przmajerczak/stm32_oscilloscope-device/device_schematic/adc_speed_switch.kicad_sch

## KiCad design device_schematic/adc_speed_switch.kicad_sch (2025-07-13)

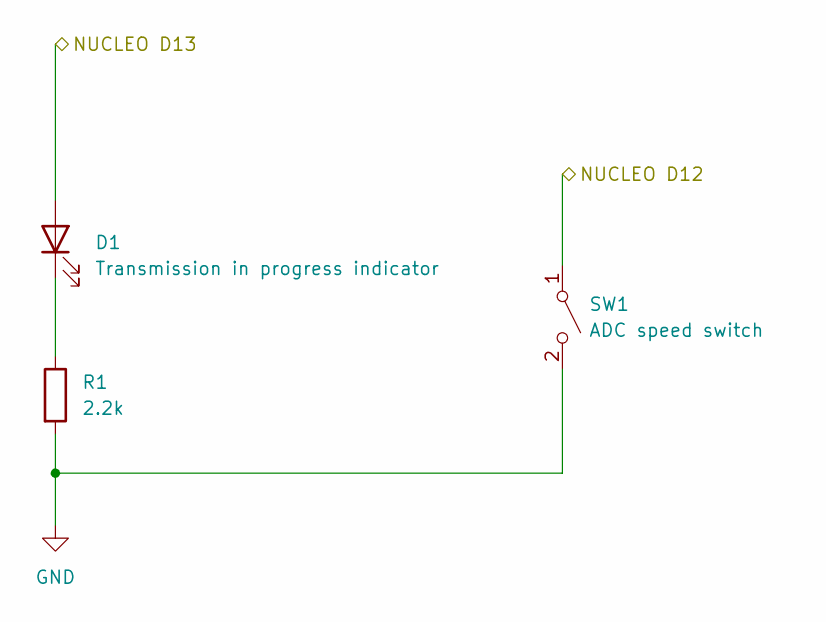
[picture p1: schematic adc_speed_switch.kicad_sch]

Parts:
D1: Transmission in progress indicator
R1: 2.2k
SW1: ADC speed switch

Connections:
NUCLEO D12: SW1.1 (A)
NUCLEO D13: D1.2 (A)
unnamed: D1.1 (K), R1.1
unnamed: R1.2, SW1.2 (B)
