przmajerczak/stm32_oscilloscope-device/device_schematic/negative_supply.kicad_sch

## KiCad design device_schematic/negative_supply.kicad_sch (2025-07-14)

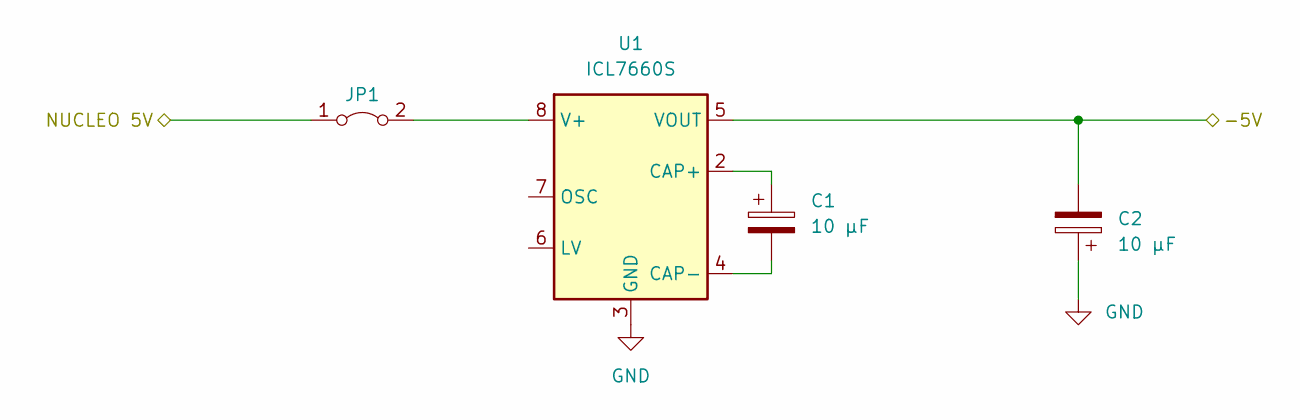
[picture p2: schematic negative_supply.kicad_sch]

Parts:
C1, C2: 10 µF
JP1: (no value)
U1: ICL7660S

Connections:
-5V: C2.2, U1.5 (VOUT)
NUCLEO 5V: JP1.1 (A)
unnamed: C1.1, U1.2 (CAP+)
unnamed: C1.2, U1.4 (CAP-)
unnamed: JP1.2 (B), U1.8 (V+)
