przmajerczak/stm32_oscilloscope-device/device_schematic/usb-c_connector.kicad_sch

## KiCad design device_schematic/usb-c_connector.kicad_sch (2025-07-14)

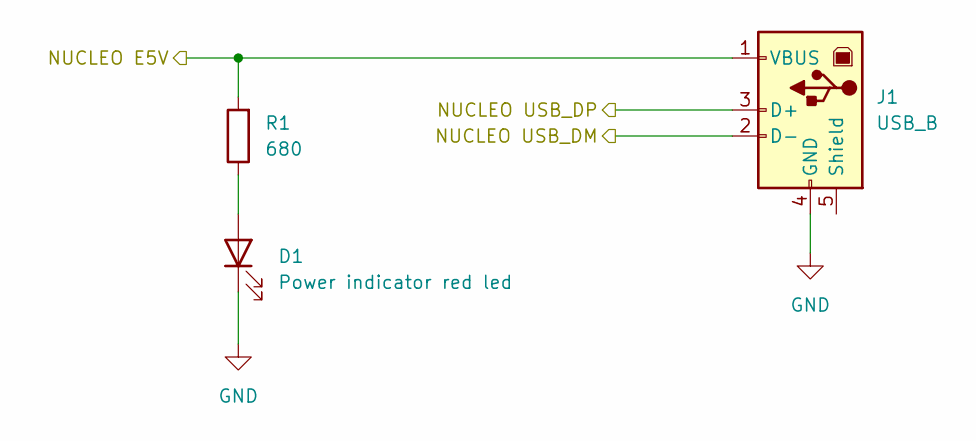
[picture p3: schematic usb-c_connector.kicad_sch]

Parts:
D1: Power indicator red led
J1: USB_B
R1: 680

Connections:
NUCLEO E5V: J1.1 (VBUS), R1.2
NUCLEO USB_DM: J1.2 (D-)
NUCLEO USB_DP: J1.3 (D+)
unnamed: D1.2 (A), R1.1
