przmajerczak/stm32_oscilloscope-device/device_schematic/subcircuits/adc_sample_time_selector.kicad_sch

## KiCad design device_schematic/subcircuits/adc_sample_time_selector.kicad_sch (2025-07-18)

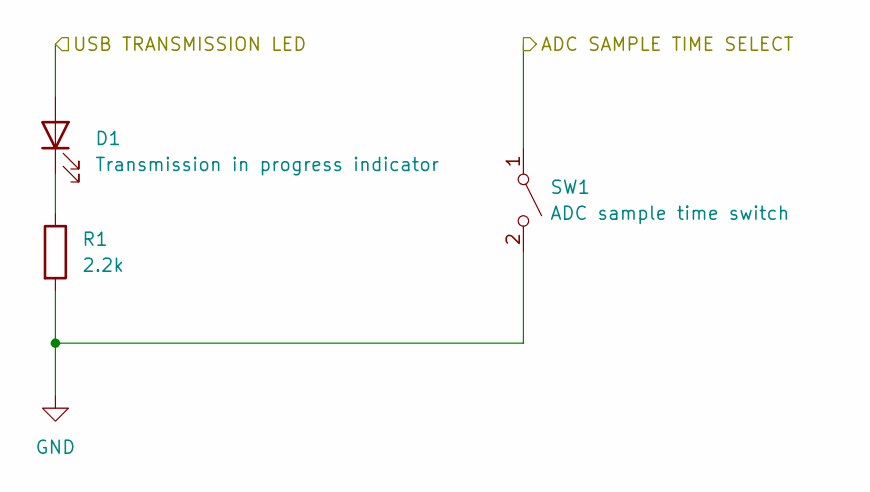
[picture p4: schematic adc_sample_time_selector.kicad_sch]

Parts:
D1: Transmission in progress indicator
R1: 2.2k
SW1: ADC sample time switch

Connections:
ADC SAMPLE TIME SELECT: SW1.1 (A)
unnamed: D1.1 (K), R1.1
unnamed: R1.2, SW1.2 (B)
USB TRANSMISSION LED: D1.2 (A)
