przmajerczak/stm32_oscilloscope-device/device_schematic/subcircuits/negative_supply_generator.kicad_sch

## KiCad design device_schematic/subcircuits/negative_supply_generator.kicad_sch (2025-07-18)

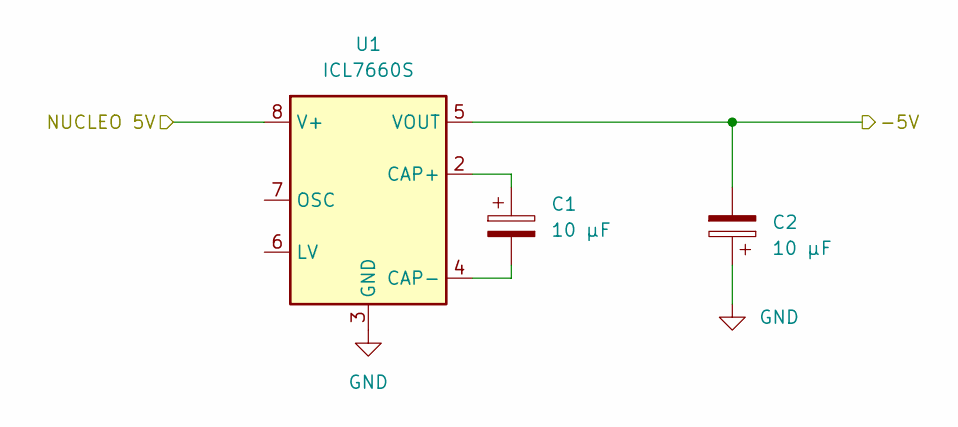
[picture p5: schematic negative_supply_generator.kicad_sch]

Parts:
C1, C2: 10 µF
U1: ICL7660S

Connections:
-5V: C2.2, U1.5 (VOUT)
NUCLEO 5V: U1.8 (V+)
unnamed: C1.1, U1.2 (CAP+)
unnamed: C1.2, U1.4 (CAP-)
