przmajerczak/stm32_oscilloscope-device/device_schematic/subcircuits/signal_processing_unit.kicad_sch

## KiCad design device_schematic/subcircuits/signal_processing_unit.kicad_sch (2025-07-18)

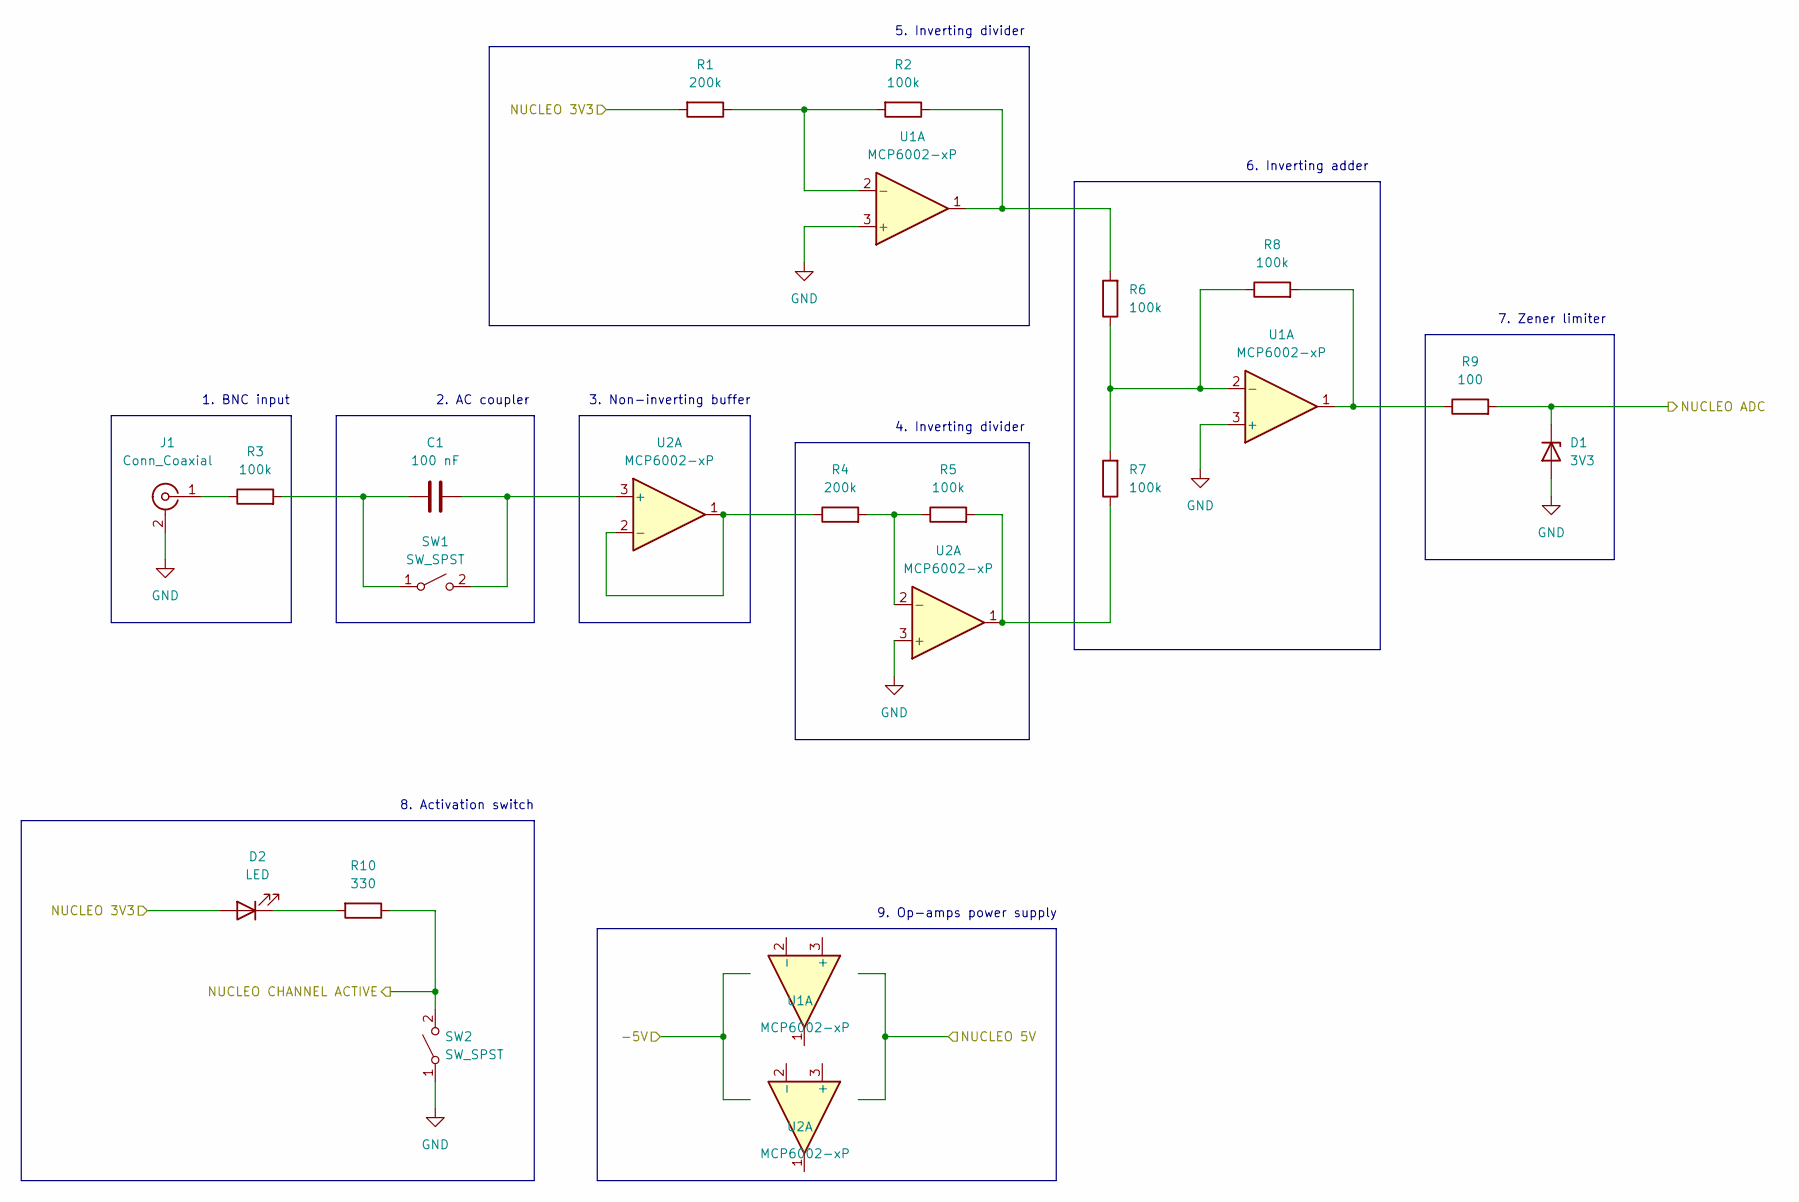
[picture p6: schematic signal_processing_unit.kicad_sch]

Parts:
C1: 100 nF
D1: 3V3
D2: LED
J1: Conn_Coaxial
R1, R4: 200k
R2, R3, R5, R6, R7, R8: 100k
R9: 100
R10: 330
SW1, SW2: SW_SPST
U1, U2: MCP6002-xP

Connections:
NUCLEO 3V3: D2.2 (A), R1.2
NUCLEO ADC: D1.1 (K), R9.2
NUCLEO CHANNEL ACTIVE: R10.1, SW2.2 (B)
unnamed: C1.1, R3.2, SW1.1 (A)
unnamed: C1.2, SW1.2 (B), U2.3 (+)
unnamed: D2.1 (K), R10.2
unnamed: J1.1 (In), R3.1
unnamed: R1.1, R2.2, U1.2 (-)
unnamed: R2.1, R6.2, U1.1
unnamed: R4.1, U2.1, U2.2 (-)
unnamed: R4.2, R5.1, U2.2 (-)
unnamed: R5.2, R7.1, U2.1
unnamed: R6.1, R7.2, R8.1, U1.2 (-)
unnamed: R8.2, R9.1, U1.1

Notes on the sheet:
3. Non-inverting buffer
9. Op-amps power supply
5. Inverting divider
6. Inverting adder
2. AC coupler
4. Inverting divider
1. BNC input
7. Zener limiter
8. Activation switch
