przmajerczak/stm32_oscilloscope-device/device_schematic/subcircuits/usb_connector.kicad_sch

## KiCad design device_schematic/subcircuits/usb_connector.kicad_sch (2025-07-18)

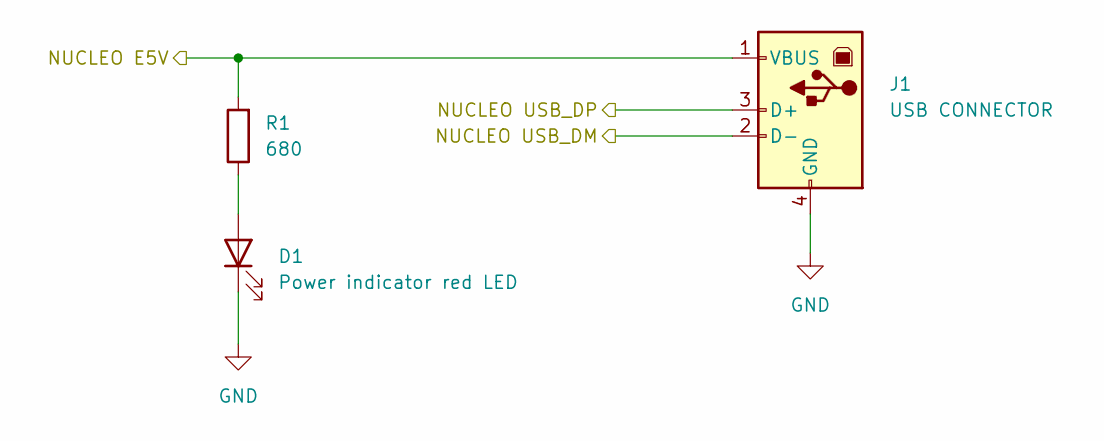
[picture p7: schematic usb_connector.kicad_sch]

Parts:
D1: Power indicator red LED
J1: USB CONNECTOR
R1: 680

Connections:
NUCLEO E5V: J1.1 (VBUS), R1.2
NUCLEO USB_DM: J1.2 (D-)
NUCLEO USB_DP: J1.3 (D+)
unnamed: D1.2 (A), R1.1
