przmajerczak/stm32_oscilloscope-device/stm32_oscilloscope-device.ioc

Mcu.UserName=STM32F439ZITx
PA10.GPIO_Label=USB_ID
PA10.Signal=USB_OTG_FS_ID
PA11.GPIO_Label=USB_DM
PA11.Signal=USB_OTG_FS_DM
PA12.GPIO_Label=USB_DP
PA12.Signal=USB_OTG_FS_DP
PA13.GPIO_Label=TMS
PA13.Signal=SYS_JTMS-SWDIO
PA14.GPIO_Label=TCK
PA14.Signal=SYS_JTCK-SWCLK
PA3.Signal=ADCx_IN3
PA5.GPIO_Label=_USB_transmission_in_progress
PA5.Signal=GPIO_Output
PA6.GPIO_Label=_ADC_sample_time_select
PA6.Signal=GPIO_Input
PA8.GPIO_Label=USB_SOF [TP1]
PA8.Signal=USB_OTG_FS_SOF
PA9.GPIO_Label=USB_VBUS
PA9.Signal=USB_OTG_FS_VBUS
PC13.GPIO_Label=USER_Btn [B1]
PC13.Signal=GPXTI13
PC14/OSC32_IN.Signal=RCC_OSC32_IN
PC15/OSC32_OUT.Signal=RCC_OSC32_OUT
PC3.Signal=ADCx_IN13
PD13.GPIO_Label=_Channel_2_active
PD13.Signal=GPIO_Input
PD6.GPIO_Label=_Channel_1_active
PD6.Signal=GPIO_Input
PG6.GPIO_Label=USB_PowerSwitchOn [STMPS2151STR_EN]
PG6.Signal=GPIO_Output
PG7.GPIO_Label=USB_OverCurrent [STMPS2151STR_FAULT]
PG7.Signal=GPIO_Input
PH0/OSC_IN.GPIO_Label=MCO [STM32F103CBT6_PA8]
PH0/OSC_IN.Signal=RCC_OSC_IN
PH1/OSC_OUT.Signal=RCC_OSC_OUT
