przmajerczak/stm32_oscilloscope-device/Inc/main.h

#define USER_Btn_Pin GPIO_PIN_13
#define USER_Btn_GPIO_Port GPIOC
#define MCO_Pin GPIO_PIN_0
#define MCO_GPIO_Port GPIOH
#define _USB_transmission_in_progress_Pin GPIO_PIN_5
#define _USB_transmission_in_progress_GPIO_Port GPIOA
#define _ADC_range_select_Pin GPIO_PIN_6
#define _ADC_range_select_GPIO_Port GPIOA
#define _Channel_2_active_Pin GPIO_PIN_13
#define _Channel_2_active_GPIO_Port GPIOD
#define USB_PowerSwitchOn_Pin GPIO_PIN_6
#define USB_PowerSwitchOn_GPIO_Port GPIOG
#define USB_OverCurrent_Pin GPIO_PIN_7
#define USB_OverCurrent_GPIO_Port GPIOG
#define USB_SOF_Pin GPIO_PIN_8
#define USB_SOF_GPIO_Port GPIOA
#define USB_VBUS_Pin GPIO_PIN_9
#define USB_VBUS_GPIO_Port GPIOA
#define USB_ID_Pin GPIO_PIN_10
#define USB_ID_GPIO_Port GPIOA
#define USB_DM_Pin GPIO_PIN_11
#define USB_DM_GPIO_Port GPIOA
#define USB_DP_Pin GPIO_PIN_12
#define USB_DP_GPIO_Port GPIOA
#define TMS_Pin GPIO_PIN_13
#define TMS_GPIO_Port GPIOA
#define TCK_Pin GPIO_PIN_14
#define TCK_GPIO_Port GPIOA
#define _Channel_1_active_Pin GPIO_PIN_6
#define _Channel_1_active_GPIO_Port GPIOD
