przmajerczak/stm32_oscilloscope-device/(commit log)

2024-06-07 Switch USB mode to Virtual Com Port
2024-06-23 Implement 1.0 interface
    Add ADC measuring and sending signal via USB
    as desribed in README.md
2024-12-30 2.0 interface introduction
    Sending dummy pre-prepared data instead of
    real ADC measurements.
2024-12-30 2.0 interface implementation
    Sending real ADC measurements instead of dummy values.
    Measurements are 1 ms apart using delay. 100 ms delay
    after each transmission
2025-01-01 Timer triggering ADC
    Enabling Timer3 ticking at 125 us and using it
    as a trigger for ADC, now fully filling the buffer
    with 800 measurements every 100 ms.
2025-01-02 2.1 interface implementation
    Adding timer2 working at maximal frequency of 168 MHz.
    Its count is sent after measurements in every transmission.
2025-02-28 Interface 2.3
    Increasing resolution, while keeping 100 ms frame length.
2025-03-02 Reference pulse wave introduction
    Adding 500 kHz square wave on G2 pin and
    2.5 kHz square wave on G3 pin for reference usage.
2025-03-02 Flash blue LED only during data transmission
2025-03-06 Timer4 accuracy improvement
    Reference signal on the pin G3 was 2230 Hz instead
    of expected 2500 Hz. Pins G2 and G3 were set to
    GPIO_SPEED_FREQ_VERY_HIGH and __HAL_TIM_CLEAR_IT
    was used in place of HAL_TIM_IRQHandler
    within TIM4_IRQHandler.
2025-03-06 Introducing flag for distinction between DMA and interrupts driven ADC
    for future use
2025-03-06 Add faster, DMA-driven ADC mode
2025-03-06 Adc range switch preparation
    Configuring D11 pin as input for driving
    USE_DMA_OVER_INTERRUPTS_FOR_ADC value.
    Green LED follows the value, but the value
    itself is not changed yet.
2025-03-08 Interface 2.4
    Sending 12000 samples instead of 10000
2025-03-08 DMA only introduction
    - total removal of interrupts-based mode
    - only DMA single-ADC mode active so far
    - transmissions and measurements limited
    to once every ~30 ms
2025-03-08 Enable triple interleaved ADC mode
2025-03-10 Dual channel ADC enabling
    IN10 channel (A1 on board) is enabled and results decoded,
    but only legacy IN3 (A0) channel is sent via USB.
2025-03-10 Add ADC sampling time selection
    depending on D11 pin state on uC wake up
2025-03-23 DMA mode correction
    Using normal (single) DMA mode instead of circular,
    with disabling and re-enabling ADC and DMA after every transmission
    [adc.c, stm32_oscilloscope-device.ioc]
2025-03-23 Channel buttons correction
    Moving reading of channel-enabling pins
    to after the transmission to ensure
    configuration consistency
2025-03-24 Sampling frequency improvement
    Adjusting DMA for single channel mode in order
    to increase sampling frequency when only one channel is active
2025-03-24 Custom ADC initialization
    Extracting code from generated ADC initialization
    to custom functions for future alignments
2025-03-24 ADC reinitialization adjustments
    Correcting number of channels confiuration for ADC
2025-03-24 Feature removal
    Removing reference frequency on G2 and G3 pins,
    together with timer 4 disable
2025-03-25 Code extraction
    Extract ADC-related code to adc_utils.h
2025-04-04 ADC Channel2 change
    Using STM's ADC channel 13 instead of 10 as
    oscilloscope's channel 2
2025-07-13 Adding device schematic as KiCad project
    Only part of circuit schematic ready so far
    [adc_speed_switch.kicad_sch, device_schematic.kicad_pcb, device_schematic.kicad_sch, negative_supply.kicad_sch, signal_processing.kicad_sch, usb-c_connector.kicad_sch]
2025-07-14 Device schematic update
    [device_schematic.kicad_sch, negative_supply.kicad_sch, signal_processing.kicad_sch, usb-c_connector.kicad_sch]
2025-07-18 Device schematic finished version
    [adc_sample_time_selector.kicad_sch, device_schematic.kicad_pcb, device_schematic.kicad_sch, negative_supply_generator.kicad_sch, nucleo-f439zi_mock.kicad_sch, signal_processing_unit.kicad_sch, usb_connector.kicad_sch]
